royalpayne/dual_zone_12v_HVAC-Controller/docs/IMG_8782.jpeg

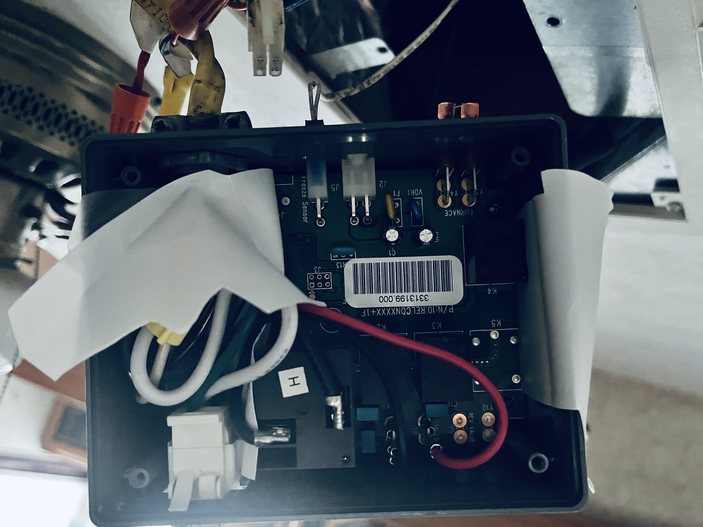
docs/IMG_8782.jpeg
