royalpayne/dual_zone_12v_HVAC-Controller/docs/IMG_8777.jpeg

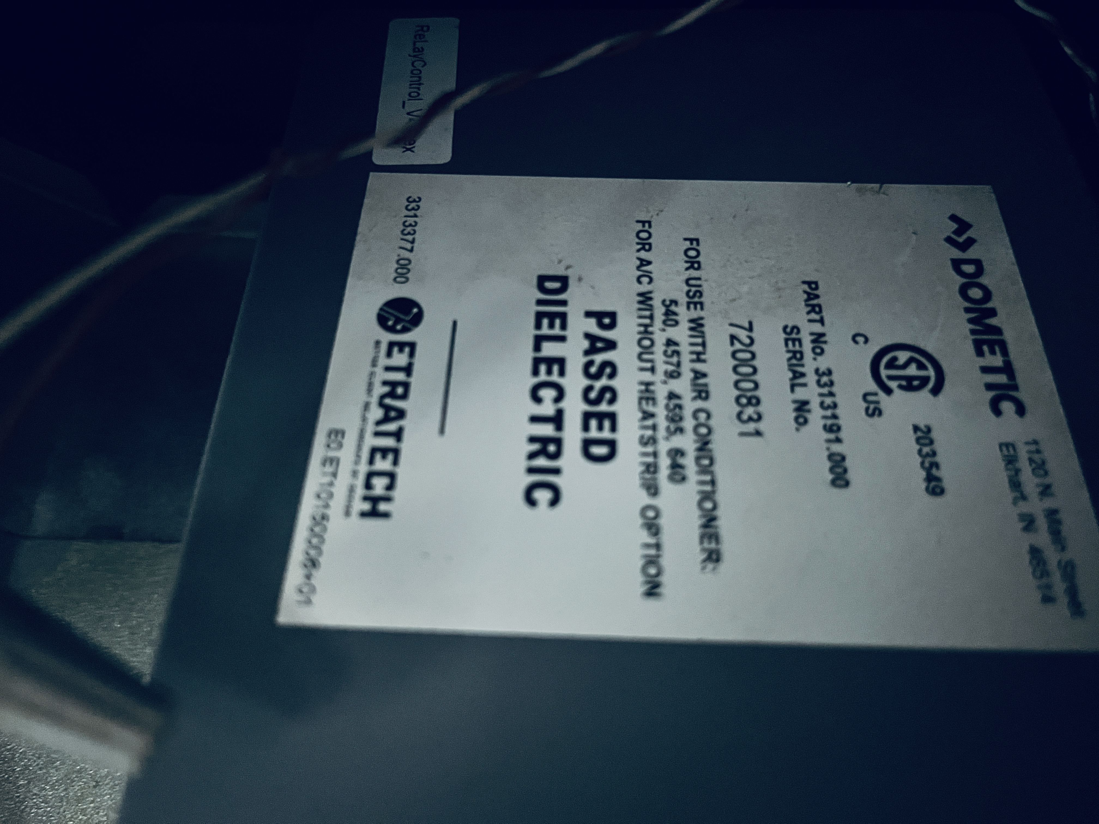
docs/IMG_8777.jpeg
