royalpayne/dual_zone_12v_HVAC-Controller/docs/IMG_8779.jpeg

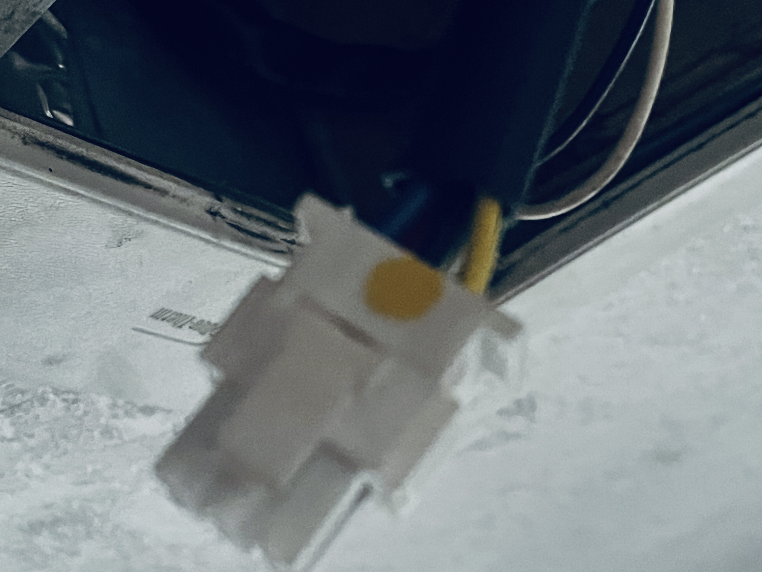
docs/IMG_8779.jpeg
