royalpayne/dual_zone_12v_HVAC-Controller/docs/IMG_8780.jpeg

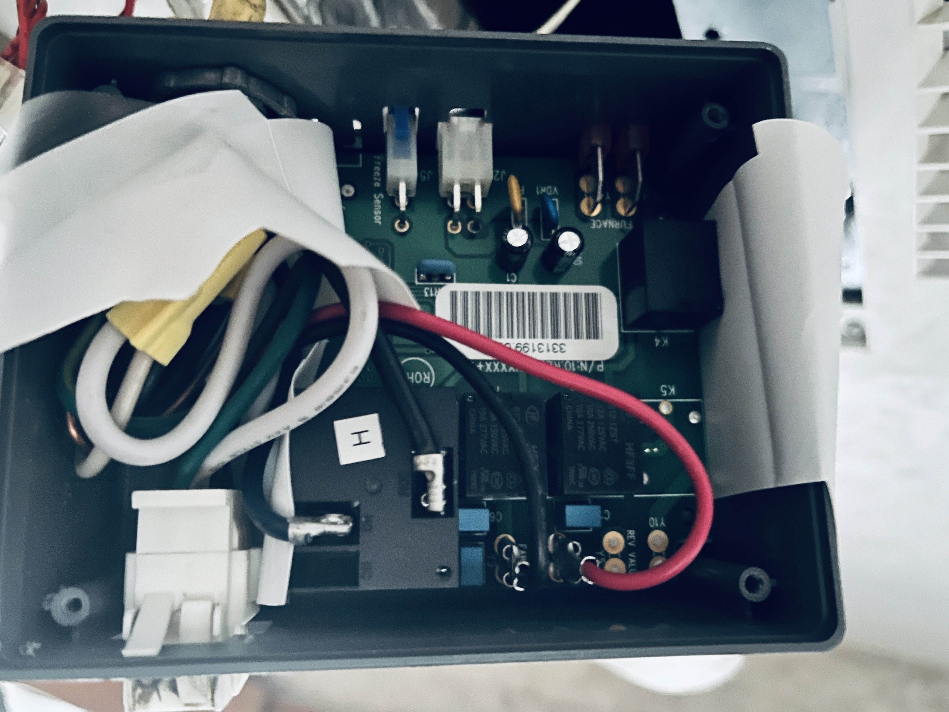
docs/IMG_8780.jpeg
