royalpayne/dual_zone_12v_HVAC-Controller/docs/IMG_8781.jpeg

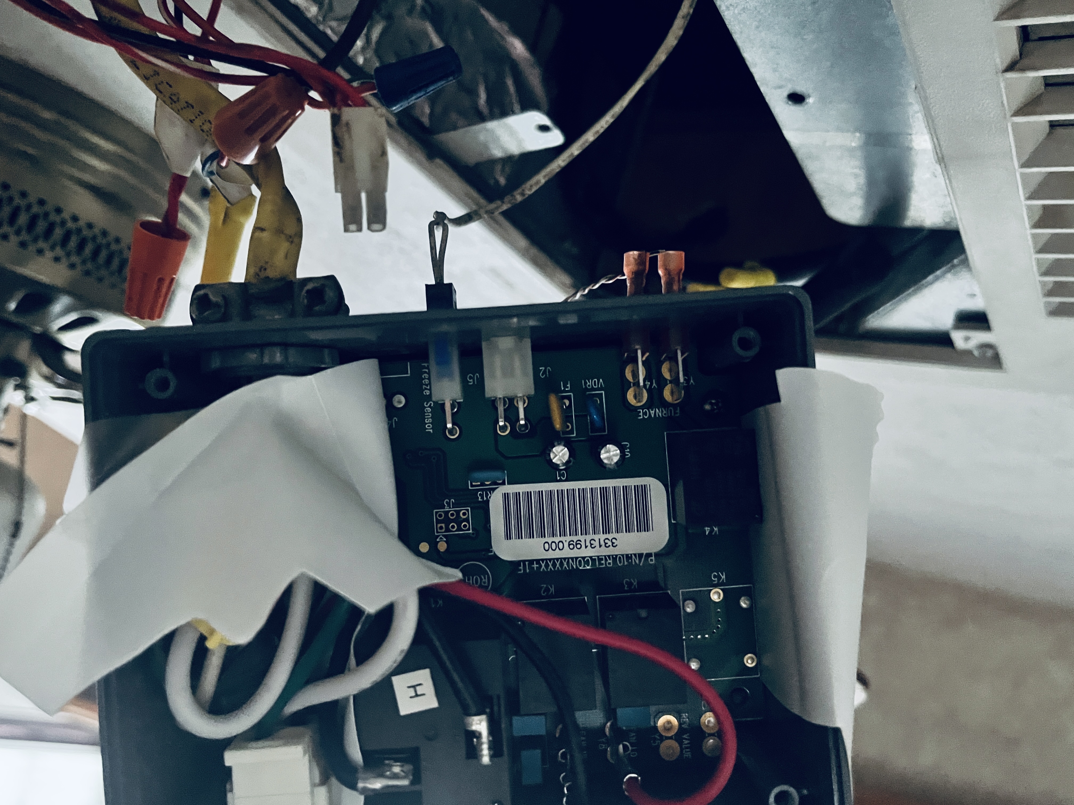
docs/IMG_8781.jpeg
