royalpayne/dual_zone_12v_HVAC-Controller/docs/oled_bme280_wiring_pro.pdf

# OLED & BME280 I2C WIRING DIAGRAM

### 3-Meter Cable: ESP32-S3 Module Thermostat Location

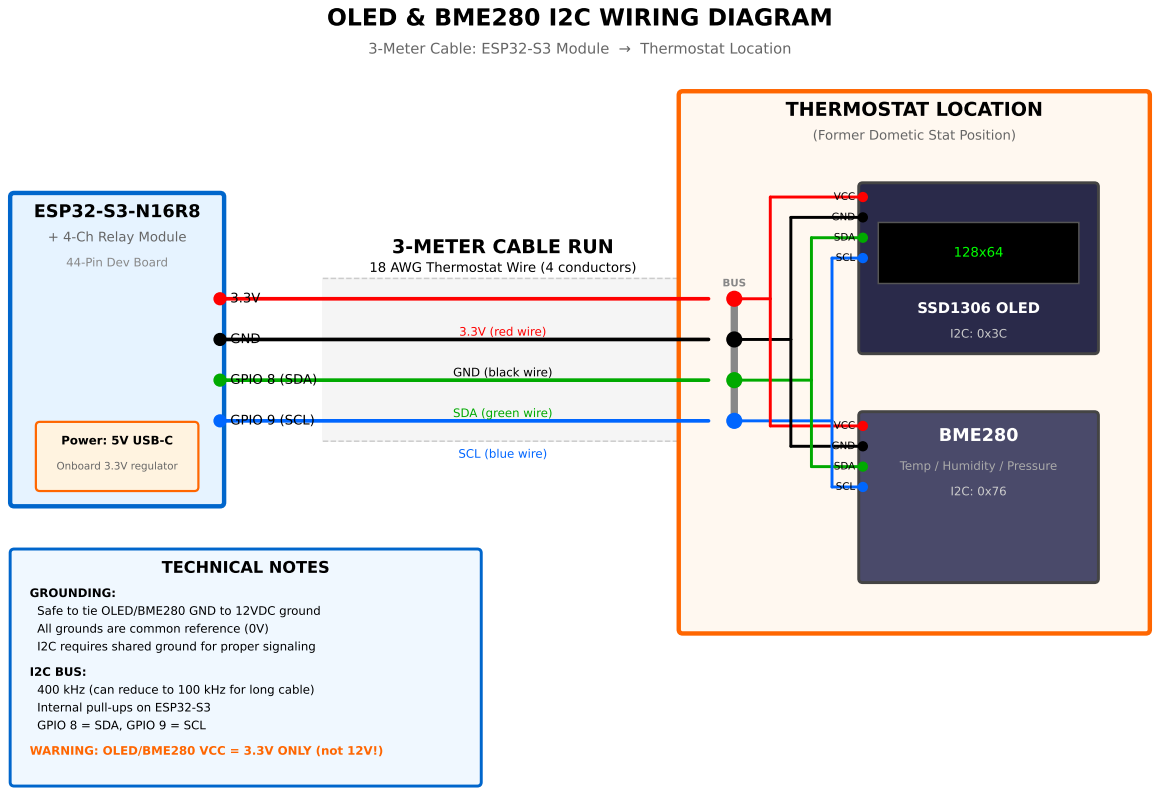
[picture p6: page 1]
ESP32-S3-N16R8; Power: 5V USB-C; Onboard 3.3V regulator; GND; GPIO 8 (SDA); GPIO 9 (SCL); 3.3V (red wire); THERMOSTAT LOCATION; BUS; SSD1306 OLED; VCC; SDA; SCL; BME280; TECHNICAL NOTES

(Former Dometic Stat Position)

+ 4-Ch Relay Module

3-METER CABLE RUN
18 AWG Thermostat Wire (4 conductors)

44-Pin Dev Board

GND (black wire)

SDA (green wire)

SCL (blue wire)

Temp / Humidity / Pressure

GROUNDING:
Safe to tie OLED/BME280 GND to 12VDC ground
All grounds are common reference (0V)
I2C requires shared ground for proper signaling

I2C BUS:
400 kHz (can reduce to 100 kHz for long cable)
Internal pull-ups on ESP32-S3
GPIO 8 = SDA, GPIO 9 = SCL

WARNING: OLED/BME280 VCC = 3.3V ONLY (not 12V!)
