royalpayne/dual_zone_12v_HVAC-Controller/docs/esp32_main_wiring_pro.pdf

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

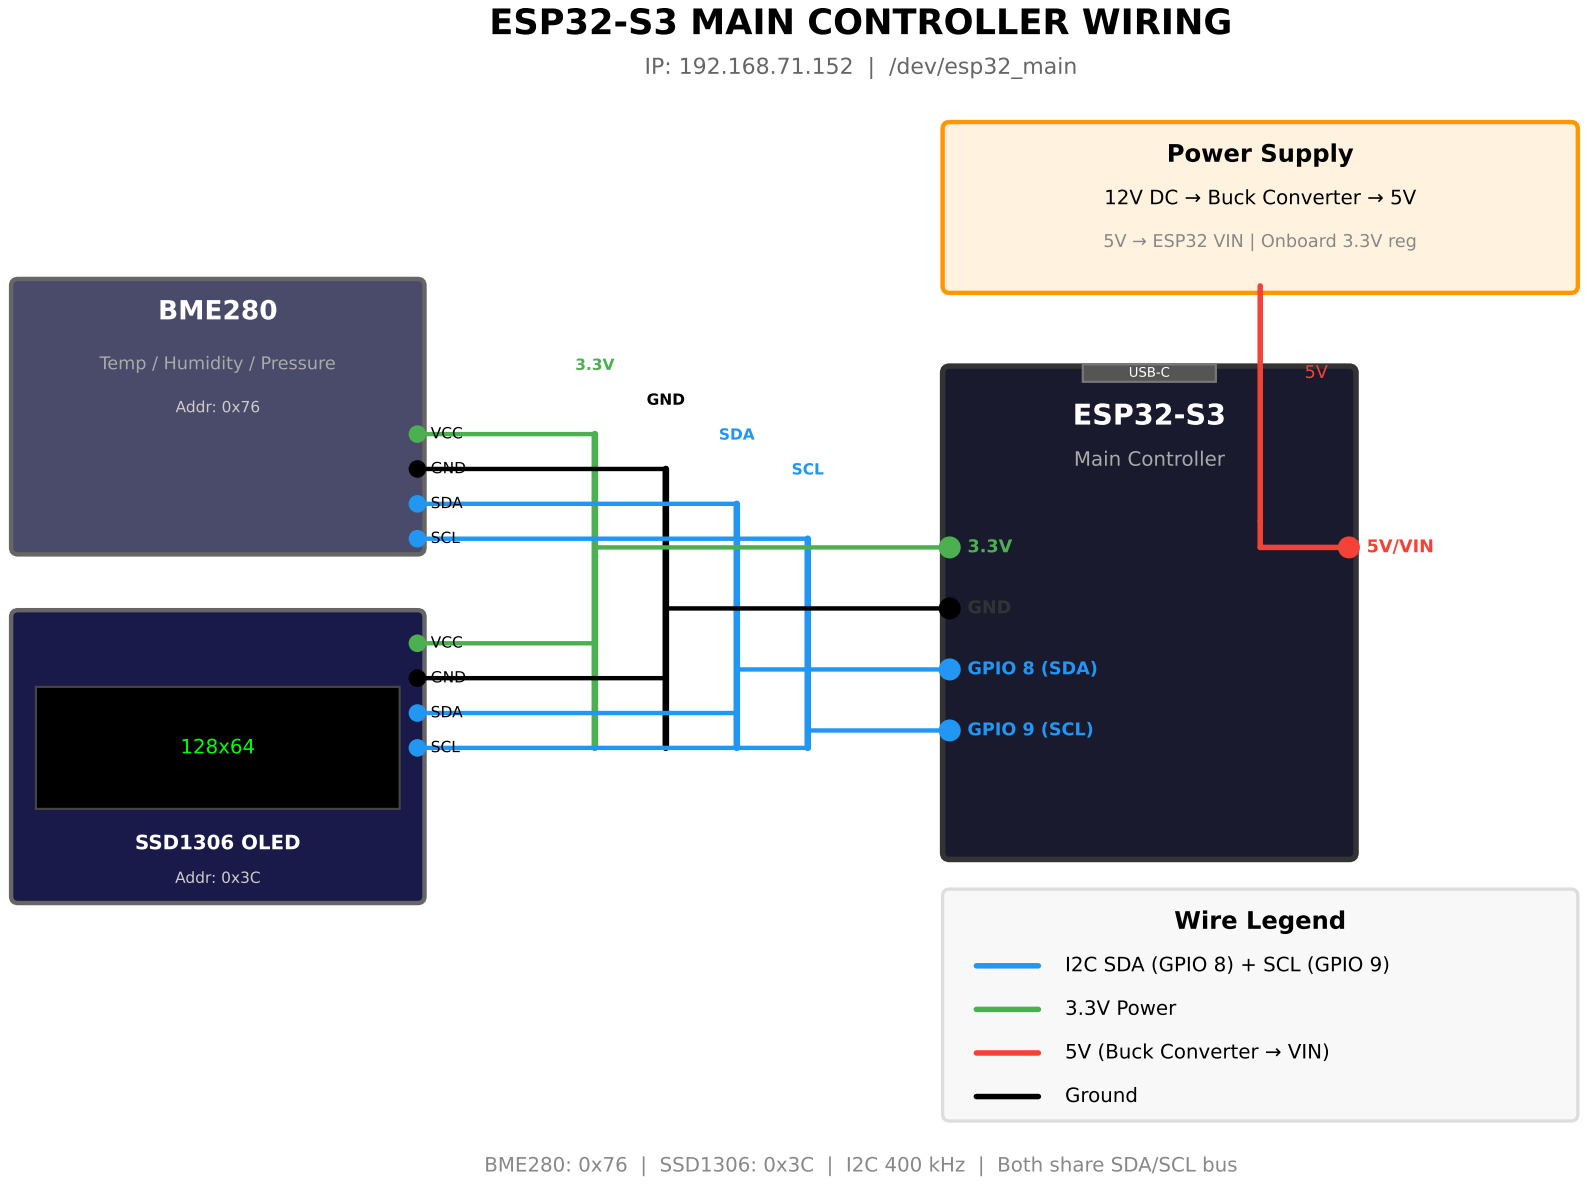
[picture p7: page 1]
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
