royalpayne/dual_zone_12v_HVAC-Controller/(list of files, drawings)

Other design files:
peterhinch_ir/images/circuits.fzz
