royalpayne/dual_zone_12v_HVAC-Controller/esp32_remote/config.py

# ESP32 Remote - Configuration
# ============================

# WiFi Settings (override in config_local.py)
WIFI_SSID = "YOUR_WIFI_SSID"
WIFI_PASSWORD = "YOUR_WIFI_PASSWORD"

# Static IP Configuration (ESP32 Remote)
STATIC_IP = "192.168.71.153"
SUBNET_MASK = "255.255.255.0"
GATEWAY = "192.168.71.1"
DNS_SERVER = "192.168.71.1"

# ESP32 Main Controller (for future API integration)
ESP32_IP = "192.168.1.100"
ESP32_PORT = 80

# Temperature Settings (in Fahrenheit)
DEFAULT_HEAT_SETPOINT = 68
DEFAULT_COOL_SETPOINT = 75
MIN_SETPOINT = 50
MAX_SETPOINT = 90

# Sensor calibration offsets (added to raw readings)
TEMP_OFFSET = -0.6      # degrees F (split-the-difference vs HTS2)
HUMIDITY_OFFSET = -3.3   # percent (split-the-difference vs HTS2)
PRESSURE_OFFSET = 0.0   # hPa

# Broadlink HTS2 calibration offsets
BL_TEMP_OFFSET = 0.6    # degrees F (split-the-difference vs BME280)
BL_HUMIDITY_OFFSET = 3.3  # percent (split-the-difference vs BME280)

# Hysteresis (prevents rapid cycling)
HYSTERESIS = 1.5

# Boost mode - portable unit kicks in when temp exceeds setpoint by this amount
BOOST_THRESHOLD = 4  # degrees F — raised from 3° (comfort avg was +0.1°, room to spare)
BOOST_STALL_TIME = 600  # seconds (10 min) - boost if rooftop AC runs this long with no temp drop

# Dehumidification (via Whynter cool mode - evaporates condensate out exhaust)
HUMIDITY_SETPOINT = 55      # % RH — trigger Whynter when exceeded
HUMIDITY_HYSTERESIS = 8     # % RH — turn off at setpoint minus this (e.g. 55-8=47%)
DEHUM_SUSTAINED_TIME = 300  # seconds (5 min) — humidity must stay above setpoint this long before activating
DEHUM_MIN_RUN_TIME = 1800   # seconds (30 min) — minimum dehum run time once started
DEHUM_MIN_OFF_TIME = 1200   # seconds (20 min) — minimum off time before restarting dehum

# Apparent temperature: adjust cooling decisions based on humidity for comfort + efficiency
# Each 10% RH above 50% feels ~1°F warmer; below 50% feels ~1°F cooler
# Effect: AC runs sooner when humid (dehumidifies), rests longer when dry (saves energy)
HUMIDITY_COMFORT_FACTOR = 0.1  # °F per 1% RH deviation from 50%

# Phase 1 Expansion Features
# CH5/CH6 relay expansion (currently disabled - no hardware)
DEHUMIDIFIER_ENABLE = False     # No standalone dehumidifier (Whynter is IR-controlled)
DEHUMIDIFIER_HUMIDITY_SETPOINT = 60  # % RH — activate dehumidifier above this
DEHUMIDIFIER_HYSTERESIS = 5     # % RH — turn off at setpoint minus this
DEHUMIDIFIER_MIN_CYCLE = 300    # seconds — minimum run/off time (5 min)

# Powered vent fan control (CH6) - MaxxFan, Fantastic Fan, etc
VENT_FAN_ENABLE = False         # No powered vent fan hardware
VENT_FAN_TEMP_DIFFERENTIAL = 5  # °F — run fan when outdoor temp is this much cooler than indoor
VENT_FAN_MAX_OUTDOOR_TEMP = 78  # °F — don't run vent fan if outdoor temp exceeds this
VENT_FAN_MIN_CYCLE = 180        # seconds — minimum run/off time (3 min)

# Short-cycle protection (minimum seconds between state changes)
MIN_CYCLE_TIME = 240  # 4 minutes — reduces short cycling, protects compressor

# Sensor Settings
SENSOR_READ_INTERVAL = 5  # seconds between readings

# Debug and dry-run modes
DEBUG = False
DRY_RUN = False

# ============================================================
# HARDWARE CONFIGURATION - ESP32-S3-N16R8 + 4-Channel Relay Module
# ============================================================
# GPIO 22-25 don't exist on ESP32-S3
# GPIO 26-37 reserved for Flash/PSRAM
# GPIO 19/20 reserved for native USB

# I2C for BME280 and OLED
I2C_SDA_PIN = 41
I2C_SCL_PIN = 40
I2C_FREQ = 400000

# 4-Channel Relay Module (active HIGH, set via jumper)
RELAY_FURNACE_PIN = 4           # Furnace dry contact closure
RELAY_COMPRESSOR_PIN = 5        # Compressor triggers SSR-40DA via 12VDC
RELAY_FAN_LOW_PIN = 6           # Rooftop AC fan low speed
RELAY_FAN_HIGH_PIN = 15         # Rooftop AC fan high speed

# Relay polarity: Active HIGH (value=1 = ON, value=0 = OFF)
RELAY_ACTIVE_LOW = False
# Compressor relay switches 12VDC to SSR-40DA (milliamp trigger), SSR switches 120VAC

# DS18B20 evaporator freeze sensor (1-Wire)
FREEZE_SENSOR_PIN = 42          # DS18B20 data pin (needs 4.7K pull-up to 3.3V)
FREEZE_THRESHOLD = 32.0         # °F — cut compressor if evaporator drops below this
FREEZE_RECOVERY = 45.0          # °F — allow compressor restart above this temp
FREEZE_CHECK_INTERVAL = 5       # seconds between freeze sensor reads

# Onboard WS2812 RGB LED
RGB_LED_PIN = 48                # WS2812 NeoPixel for status indication

# Broadlink RM4 Mini (WiFi IR blaster - replaces direct IR hardware)
BROADLINK_IP = None       # Set after discovery, or static IP in config_local.py
BROADLINK_TIMEOUT = 3     # UDP timeout seconds
BROADLINK_RETRIES = 3     # Retry count for failed commands

# I2C Addresses
BMP280_ADDR = 0x76
OLED_ADDR = 0x3C

# Display Settings
DISPLAY_WIDTH = 128
DISPLAY_HEIGHT = 64

# ============================================================
# CONSTANTS
# ============================================================

# Operating Modes
MODE_OFF = 0
MODE_HEAT = 1
MODE_COOL = 2
MODE_AUTO = 3

MODE_NAMES = {
    MODE_OFF: "OFF",
    MODE_HEAT: "HEAT",
    MODE_COOL: "COOL",
    MODE_AUTO: "AUTO"
}

# Fan Speed (no medium - only 2 speeds to fit 5-wire cable)
FAN_OFF = 0
FAN_LOW = 1
FAN_HIGH = 2
FAN_AUTO = 3

FAN_NAMES = {
    FAN_OFF: "Off",
    FAN_LOW: "Low",
    FAN_HIGH: "High",
    FAN_AUTO: "Auto"
}

# Compressor protection (seconds)
COMPRESSOR_MIN_OFF_TIME = 180   # 3 minutes between off→on
FAN_PRE_RUN = 3                 # Fan starts 3s before compressor
FAN_POST_RUN = 30               # Fan runs 30s after compressor stops

# ============================================================
# LOCAL OVERRIDES
# ============================================================

try:
    from config_local import *
except ImportError:
    pass
