royalpayne/dual_zone_12v_HVAC-Controller/main.py

# RV Thermostat - Main Entry Point
# ================================
# 
# Upload all .py files to your ESP32, then reset.
# Connect to the WiFi and open the IP address in your browser.

import time
import network
from machine import Pin, I2C

import config
from sensor import SensorHub
from ssd1306 import SSD1306_I2C
from display import ThermostatDisplay
from remote_client import RemoteClient
from thermostat_remote import RemoteThermostatController
from webserver import ThermostatWebServer
from scheduler import Scheduler

# Remote ESP32 IP (can be overridden in config_local.py)
REMOTE_IP = getattr(config, 'REMOTE_IP', '192.168.71.153')


def connect_wifi(display):
    """Connect to WiFi network with static IP"""
    wlan = network.WLAN(network.STA_IF)

    # On warm restart (OTA deploy), WiFi is already connected — skip re-init
    # to avoid tearing down the network stack (ESP32-S3 fails to reconnect)
    if wlan.active() and wlan.isconnected():
        ip = wlan.ifconfig()[0]
        print(f"Already connected: {ip}")
        if display:
            display.draw_wifi_status(True, ip)
        return ip

    # Full init sequence for cold boot
    wlan.active(False)
    time.sleep(0.5)
    wlan.active(True)
    time.sleep(1)

    # Configure static IP before connecting
    wlan.ifconfig((config.STATIC_IP, config.SUBNET_MASK, config.GATEWAY, config.DNS_SERVER))
    print(f"Static IP configured: {config.STATIC_IP}")

    print(f"Connecting to {config.WIFI_SSID}...")
    if display:
        display.draw_wifi_status(False)

    # ESP32 needs disconnect before connect
    wlan.disconnect()
    time.sleep(0.5)

    try:
        wlan.connect(config.WIFI_SSID, config.WIFI_PASSWORD)
    except OSError as e:
        print(f"Connect error: {e}, retrying...")
        time.sleep(1)
        wlan.connect(config.WIFI_SSID, config.WIFI_PASSWORD)

    # Wait for connection with timeout
    max_wait = 20
    while max_wait > 0:
        if wlan.isconnected():
            break
        max_wait -= 1
        print(".", end="")
        time.sleep(1)

    if not wlan.isconnected():
        print("\nWiFi connection failed!")
        if display:
            display.draw_error("WiFi Failed")
        return None

    ip = wlan.ifconfig()[0]
    print(f"\nConnected: {ip}")
    if display:
        display.draw_wifi_status(True, ip)
    time.sleep(2)
    return ip


def main():
    """Main entry point"""
    # Initialize I2C
    i2c = I2C(0, 
              sda=Pin(config.I2C_SDA_PIN), 
              scl=Pin(config.I2C_SCL_PIN), 
              freq=config.I2C_FREQ)
    
    # Initialize OLED display
    try:
        oled = SSD1306_I2C(config.DISPLAY_WIDTH, config.DISPLAY_HEIGHT, i2c, config.OLED_ADDR)
        display = ThermostatDisplay(oled)
        display.draw_startup()
    except Exception as e:
        print(f"OLED init failed: {e}")
        display = None
    
    # Initialize sensors (BME280/BMP280)
    sensor = SensorHub(i2c)
    sensor_status = sensor.get_status()
    print(f"Sensor: {sensor_status['sensor_type']}")
    
    # Connect to WiFi
    if display:
        ip = connect_wifi(display)
    else:
        ip = None
        wlan = network.WLAN(network.STA_IF)
        wlan.active(True)
        if not wlan.isconnected():
            wlan.connect(config.WIFI_SSID, config.WIFI_PASSWORD)
            time.sleep(10)
        if wlan.isconnected():
            ip = wlan.ifconfig()[0]
    
    # Start WebREPL for over-the-air updates (port 8266)
    if ip:
        import webrepl
        webrepl.start()
        print(f"WebREPL: ws://{ip}:8266")

    # Sync RTC from NTP server
    if ip:
        import ntptime
        ntptime.host = getattr(config, 'NTP_HOST', 'pool.ntp.org')
        for _ntp_attempt in range(3):
            try:
                ntptime.settime()
                _lt = time.localtime(time.time() + config.TIMEZONE_OFFSET * 3600)
                print(f"NTP synced: {_lt[0]}-{_lt[1]:02d}-{_lt[2]:02d} {_lt[3]:02d}:{_lt[4]:02d}:{_lt[5]:02d}")
                break
            except Exception as e:
                print(f"NTP attempt {_ntp_attempt + 1} failed: {e}")
                time.sleep(1)
        else:
            print("NTP sync failed — timestamps will be inaccurate")

    # Initialize remote ESP32 client for relay/IR control
    remote = RemoteClient(REMOTE_IP)
    print(f"Remote ESP32 at {REMOTE_IP}")

    # Initialize thermostat controller (controls remote ESP32)
    thermostat = RemoteThermostatController(remote)

    # Initialize scheduler
    scheduler = Scheduler(thermostat)

    # Initialize web server (pass remote client for direct API access)
    webserver = ThermostatWebServer(thermostat, scheduler, remote)
    if ip:
        webserver.start()
        print(f"Open http://{ip} in your browser")
    
    # Initialize USB battery keep-alive (prevents auto-shutoff)
    keepalive_pin = None
    if getattr(config, 'KEEPALIVE_ENABLED', False):
        try:
            keepalive_pin = Pin(config.KEEPALIVE_PIN, Pin.OUT)
            keepalive_pin.off()
            print(f"USB keep-alive enabled on GPIO {config.KEEPALIVE_PIN}")
        except Exception as e:
            print(f"Keep-alive init failed: {e}")

    # Main loop
    last_sensor_read = 0
    last_keepalive = 0
    last_history_record = 0
    history_interval = getattr(config, 'HISTORY_INTERVAL', 60)

    print("Thermostat running... Press Ctrl+C to stop")
    
    while True:
        try:
            # Handle web requests
            webserver.handle_requests()
            
            # Read sensors periodically
            now = time.time()

            # USB battery keep-alive pulse (draw current to prevent auto-shutoff)
            if keepalive_pin and (now - last_keepalive >= config.KEEPALIVE_INTERVAL):
                keepalive_pin.on()
                time.sleep_ms(config.KEEPALIVE_PULSE_MS)
                keepalive_pin.off()
                last_keepalive = now

            if now - last_sensor_read >= config.SENSOR_READ_INTERVAL:
                temp_f, humidity, pressure = sensor.read()
                thermostat.update_readings(temp_f, humidity, pressure)
                last_sensor_read = now
                
                # Run scheduler (checks time-based mode changes)
                scheduler.run()

                # Run control logic
                thermostat.run_control_loop()
                
                # Record history snapshot for data logging
                if now - last_history_record >= history_interval:
                    try:
                        webserver.record_snapshot()
                    except Exception as e:
                        print(f"History record error: {e}")
                    last_history_record = now

                # Update display
                if display:
                    display.draw_main_screen(
                        temp_f, humidity, pressure,
                        thermostat.mode,
                        thermostat.heat_setpoint,
                        thermostat.cool_setpoint,
                        thermostat.heating_active,
                        thermostat.cooling_active
                    )
            
            time.sleep(0.1)
            
        except KeyboardInterrupt:
            print("\nStopping...")
            break
        except Exception as e:
            print(f"Error: {e}")
            time.sleep(1)


if __name__ == "__main__":
    main()
