royalpayne/dual_zone_12v_HVAC-Controller/_restart.py

# _restart.py — warm restart helper (exec'd via WebREPL after OTA upload)
# Purges cached user modules so fresh code loads from flash, then re-runs main.py.
# WiFi + WebREPL stay up because their modules are preserved.
import sys
import gc

_keep = set('sys gc machine network webrepl _webrepl websocket socket'
            ' uos os micropython esp esp32 time struct io json errno'
            ' select binascii hashlib collections re math _thread ssl'
            ' ntptime framebuf btree onewire ds18x20'.split())
n = 0
for _m in list(sys.modules):
    if _m not in _keep:
        del sys.modules[_m]
        n += 1
del _keep
gc.collect()
print('Purged', n, 'modules, free=', gc.mem_free())
# Clear I2C bus before re-running main — 9 SCL pulses releases any stuck slave
try:
    import config as _cfg
    from machine import Pin
    import time as _t
    _scl = Pin(_cfg.I2C_SCL_PIN, Pin.OUT)
    for _ in range(9):
        _scl.value(1); _t.sleep_us(5)
        _scl.value(0); _t.sleep_us(5)
    _scl.value(1)
    del _scl, _cfg, _t, Pin
except Exception:
    pass

# exec main.py then call main() — __name__ != '__main__' in exec context
_ns = {}
exec(open('main.py').read(), _ns)
_ns['main']()
