royalpayne/dual_zone_12v_HVAC-Controller/esp32_remote/ssd1306.py

# SSD1306 OLED Driver for MicroPython
# 128x64 I2C display

from micropython import const
import framebuf

# Commands
SET_CONTRAST = const(0x81)
SET_ENTIRE_ON = const(0xA4)
SET_NORM_INV = const(0xA6)
SET_DISP = const(0xAE)
SET_MEM_ADDR = const(0x20)
SET_COL_ADDR = const(0x21)
SET_PAGE_ADDR = const(0x22)
SET_DISP_START_LINE = const(0x40)
SET_SEG_REMAP = const(0xA0)
SET_MUX_RATIO = const(0xA8)
SET_COM_OUT_DIR = const(0xC0)
SET_DISP_OFFSET = const(0xD3)
SET_COM_PIN_CFG = const(0xDA)
SET_DISP_CLK_DIV = const(0xD5)
SET_PRECHARGE = const(0xD9)
SET_VCOM_DESEL = const(0xDB)
SET_CHARGE_PUMP = const(0x8D)


class SSD1306_I2C(framebuf.FrameBuffer):
    def __init__(self, width, height, i2c, addr=0x3C):
        self.i2c = i2c
        self.addr = addr
        self.width = width
        self.height = height
        self.pages = height // 8
        self.buffer = bytearray(self.pages * width)
        super().__init__(self.buffer, width, height, framebuf.MONO_VLSB)
        self._init_display()

    def _init_display(self):
        for cmd in (
            SET_DISP | 0x00,  # Display off
            SET_MEM_ADDR, 0x00,  # Horizontal addressing
            SET_DISP_START_LINE | 0x00,
            SET_SEG_REMAP | 0x01,  # Column 127 mapped to SEG0
            SET_MUX_RATIO, self.height - 1,
            SET_COM_OUT_DIR | 0x08,  # Scan from COM[N] to COM0
            SET_DISP_OFFSET, 0x00,
            SET_COM_PIN_CFG, 0x12 if self.height == 64 else 0x02,
            SET_DISP_CLK_DIV, 0x80,
            SET_PRECHARGE, 0xF1,
            SET_VCOM_DESEL, 0x30,
            SET_CONTRAST, 0xFF,
            SET_ENTIRE_ON,  # Output follows RAM
            SET_NORM_INV,  # Not inverted
            SET_CHARGE_PUMP, 0x14,  # Enable charge pump
            SET_DISP | 0x01,  # Display on
        ):
            self._write_cmd(cmd)
        self.fill(0)
        self.show()

    def _write_cmd(self, cmd):
        self.i2c.writeto(self.addr, bytes([0x80, cmd]))

    def _write_data(self, buf):
        self.i2c.writeto(self.addr, bytes([0x40]) + buf)

    def show(self):
        self._write_cmd(SET_COL_ADDR)
        self._write_cmd(0)
        self._write_cmd(self.width - 1)
        self._write_cmd(SET_PAGE_ADDR)
        self._write_cmd(0)
        self._write_cmd(self.pages - 1)
        self._write_data(self.buffer)

    def poweroff(self):
        self._write_cmd(SET_DISP | 0x00)

    def poweron(self):
        self._write_cmd(SET_DISP | 0x01)

    def contrast(self, contrast):
        self._write_cmd(SET_CONTRAST)
        self._write_cmd(contrast)

    def invert(self, invert):
        self._write_cmd(SET_NORM_INV | (invert & 1))
