royalpayne/dual_zone_12v_HVAC-Controller/(commit log)

2026-01-31 Migrate remote controller from Raspberry Pi Pico W to ESP32
    Major Changes:
    - Updated pin configurations to ESP32 GPIO layout
    * I2C: GPIO 0,1 → 21,22
    * DHT11: GPIO 2 → 4
    * Relays: GPIO 15,16 → 25,26
    * IR: GPIO 17 → 18 (added GPIO 19 for RX)
    - Updated WiFi initialization for ESP32
    * Added wlan.active(False/True) sequence
    * Added wlan.disconnect() before connect
    * Added OSError exception handling
    - Created boot.py for ESP32 auto-start
    * Automatically runs main.py on boot
    * Includes error handling and reporting
    - Fixed sensor formatting bugs
    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
    [bmp280.py, boot.py, config.py, config_dev.py, config_prod.py, config_test.py, display.py, env.py]
2026-01-31 Remove all Raspberry Pi Pico references
    Changes:
    - Renamed pico_remote/ → esp32_remote/
    - Renamed deploy_pico_remote.sh → deploy_esp32_remote.sh
    - Renamed class PicoAPI → RemoteAPI
    - Updated all documentation references
    - Changed "Pico Remote" → "ESP32 Remote" in code
    - Updated API variable names (PICO_IP → REMOTE_IP)
    All references to Pico hardware removed from codebase.
2026-01-31 Final cleanup: Remove all remaining Pico references
    - Project description now refers to dual ESP32 system
    - pico_client.py → remote_client.py
    - test_pico.py → test_remote.py
    - API endpoints updated
    - All documentation references cleaned up
    Raspberry Pi Pico completely removed from project.
2026-01-31 Complete Pico removal: Fix all remaining references
    Fixed:
    - claude.md: API endpoints and communication descriptions
    - config.py/config_local.py: File headers
    - thermostat.py: File header
    - Last updated message clarified
    Project now fully references ESP32 only.
    [config.py, thermostat.py]
2026-01-31 Add migration success report
    Comprehensive documentation of successful Pico W → ESP32 migration:
    - All completion criteria met
    - System running and stable
    - API server functional
    - Documentation complete
    - Ready for hardware testing phase
    Migration Status: ✅ COMPLETE
2026-01-31 Add comprehensive SVG wiring diagram and fix deployment script
    - Created dual_esp32_wiring.svg with complete hardware layout
    - Color-coded wiring with no overlapping connections
    - Shows ESP32 Main and ESP32 Remote configurations
    - Fixed deploy_esp32_remote.sh to work with running program
    - Changed device detection to simple file check (no exec needed)
2026-01-31 Update README.md for dual ESP32 architecture
    - Changed title from "Pico W" to "Dual ESP32 System"
    - Updated hardware descriptions for both ESP32s
    - Added reference to wiring/dual_esp32_wiring.svg
    - Updated pin mappings from Pico to ESP32 GPIO
    - Revised installation instructions for ESP32 deployment
    - Added API testing commands
2026-01-31 Create separate wiring diagrams for each ESP32
    - Split dual_esp32_wiring.svg into two focused diagrams
    - esp32_main_wiring.svg: Main controller (BMP280 + OLED)
    - esp32_remote_wiring.svg: Remote controller (full HVAC hardware)
    - Cleaner layouts with no overlapping connections
    - Power distribution shown as reference only
    - Color-coded wiring with detailed legends
    - Hardware notes included on each diagram
    - Updated README.md to reference both diagrams
2026-01-31 Remove old dual_esp32_wiring.svg
    Replaced with cleaner separate diagrams:
    - esp32_main_wiring.svg
    - esp32_remote_wiring.svg
2026-01-31 Redesign wiring diagrams with visible GPIO labels
    - ESP32 pins now extend outward with labels positioned clear of wires
    - All wiring routes below/around ESP32 board to avoid covering labels
    - Gold pin connectors clearly visible on all components
    - Improved readability with larger, golden GPIO labels
    - Wire paths designed to avoid text overlap
    - Maintains color-coding: red (power), black (ground), green (SDA),
    blue (SCL), magenta (data), orange (relay), pink (IR)
2026-01-31 Add BME280 support with auto-detection
    Hardware:
    - Updated ESP32 Main wiring diagram for BME280 (6 pins)
    - BME280 uses I2C mode: VCC, GND, SCL, SDA (MISO and CS unused)
    - Shows unused SPI pins greyed out on diagram
    - I2C address: 0x76 (same as BMP280)
    Software:
    - Created bme280.py driver with full humidity support
    - Updated sensor.py to auto-detect BME280 or BMP280
    - BME280 provides temp + humidity + pressure (replaces BMP280 + DHT11)
    - Backward compatible with existing BMP280 setups
    - DHT11 used as backup if BME280 humidity fails
    Benefits:
    - Single sensor for all measurements on ESP32 Main
    - More accurate humidity than DHT11
    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
    [bme280.py, sensor.py]
2026-01-31 Add ESP32 Main setup and deployment scripts
    - flash_esp32_main.sh: Flash MicroPython firmware to new ESP32
    - deploy_esp32_main.sh: Deploy all main controller files
    - Includes BME280 driver in deployment
    - Auto-detects config_local.py for WiFi credentials
    - Scripts accept device path as optional parameter
    Usage:
    ./flash_esp32_main.sh /dev/ttyUSB0
    ./deploy_esp32_main.sh /dev/ttyUSB0
2026-01-31 Complete ESP32 Main setup and deployment
    - Fixed flash_esp32_main.sh with current MicroPython firmware URL
    - Updated deploy_esp32_main.sh to include env.py and pico_client.py
    - Successfully deployed ESP32 Main at 192.168.71.152
    - API server running and responding correctly
    - BME280 driver ready for hardware connection
    Tested and verified:
    - WiFi connection established
    - Web server running on port 80
    - API returning valid JSON
    - Sensor auto-detection working (ENODEV expected without hardware)
    Next: Wire BME280 and OLED to ESP32 Main
2026-01-31 Simplify web UI and update remote controller references
    - Remove schedule UI (card, CSS, JavaScript) to reduce memory usage
    - Update all "Pico" references to "Remote" throughout interface
    - Add ESP32 Remote flash and deployment scripts
    - Simplify scheduler from 7 days to weekday/weekend format
    - Reduce HTML size from ~407 to ~312 lines (7.5KB payload)
    Website now loads reliably on ESP32 with 112KB free memory.
2026-01-31 Add graphical humidity and pressure indicators
    OLED Display:
    - Add water droplet icon (7x9 pixels) next to humidity reading
    - Add pressure trend arrows: ↑ rising, ↓ falling, → steady
    - Track pressure history (3 readings) to calculate trend
    - Threshold: ±0.5 hPa for rising/falling detection
    Web UI:
    - Add 💧 emoji before humidity percentage
    - Add dynamic pressure trend arrow that updates with API
    - Track pressure history on server side
    - Include pressure_trend field in API /status response
    Both displays now provide visual context for environmental data
    making it easier to understand conditions at a glance.
2026-01-31 Refactor pico to remote naming and fix slider UX issues
    - Rename pico_client.py to remote_client.py with RemoteClient class
    - Update all references from "pico" to "remote" across codebase
    - Increase socket timeout from 0.5s to 2.0s for reliable ESP32-to-ESP32 communication
    - Add JavaScript debouncing (300ms) to prevent slider conflicts
    - Add adjustment flags to prevent polling updates during user interaction
    - Fix sensor display reliability issues
    - Various sensor and display improvements
    [display.py, main.py, remote_client.py, sensor.py, thermostat_remote.py, webserver.py]
2026-01-31 Set default mode to AUTO and increase sensor polling to 10 seconds
    - Add DEFAULT_MODE config setting (default: AUTO)
    - Update thermostat to use config.DEFAULT_MODE instead of hardcoded MODE_OFF
    - Increase SENSOR_READ_INTERVAL from 5 to 10 seconds for reduced overhead
2026-01-31 Fix slider race condition with improved debouncing
    - Increase debounce timeout from 300ms to 500ms
    - Add 500ms delay before clearing adjusting flags after API response
    - Prevents 3-second polling from interfering with slider updates
    - Fixes cool slider jumping when moving to higher temperatures
    - Applied to all four sliders (heat, cool, remote heat, remote cool)
    [webserver.py]
2026-01-31 Fix slider jumping by removing immediate updates after API calls
    - Remove upd(d) and updRemote(d) calls after setpoint API responses
    - Increase protection delay from 500ms to 1000ms after API completes
    - Let regular 3-second polling handle slider updates naturally
    - Eliminates race condition between API response and polling cycle
    - Slider now stays exactly where user sets it
    [webserver.py]
2026-01-31 Display both heat and cool setpoints on OLED screens
    - Update draw_main_screen() to accept both heat_setpoint and cool_setpoint
    - Display format: "H:68 C:75" instead of single setpoint
    - Applied to both main ESP32 and remote ESP32 displays
    - Shows both setpoints regardless of current mode
2026-02-03 Upgrade Main to ESP32-S3 with BME280, add humidity/pressure to web UI
    - Update Main config for ESP32-S3 I2C pins (GPIO 8/9)
    - Add BME280 driver to Remote ESP32
    - Fix pressure units (Pa to hPa conversion)
    - Display humidity and pressure for both Main and Remote zones
    - Show humidity as whole number percentages
    - Update IR transmitter to use digital signal (module handles carrier)
    - Add IR LED and receiver test scripts
    [bme280.py, config.py, ir_whynter.py, main.py, remote_client.py, sensor.py, thermostat.py, webserver.py]
2026-02-03 Add Arduino IR transmitter sketch for testing
    - Uses IRremoteESP8266 library with proper 38kHz carrier
    - Alternative to MicroPython for IR testing
    - Hardware IR LED still needs fixing
2026-02-04 Switch IR transmission to ESP32 RMT hardware for reliable control
    Updated WhynterIR to use ESP32's RMT peripheral instead of software PWM
    for more precise IR timing. Tested and working at 1 meter distance with
    2N2222 transistor driver circuit on 5V power.
    - Use RMT hardware for 38kHz carrier generation and precise timing
    - Add peterhinch IR library for capture/transmit support
    - Include test scripts for debugging IR transmission
    - Add wiring diagram for transistor driver circuit
    - Update claude.md with testing results and working configuration
    Hardware requirements:
    - 2N2222 NPN transistor for LED driver
    - 5V power supply for maximum LED brightness
    - 22Ω current-limiting resistor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
    [circuits.fzz]
2026-02-04 Update IR testing log with 2026-02-04 results
    Testing revealed that 4 IR LEDs with 2N2222 transistor driver on 5V
    can control the Whynter A/C, but without proper current limiting the
    operation is inconsistent at 1 meter range.
    Key findings:
    - ESP32 RMT hardware transmission working correctly
    - NEC protocol IR code captured and validated
    - Transistor circuit functional but needs current regulation
    - Inconsistent results without resistor (LEDs may overheat)
    Next steps:
    - Install 22Ω resistor when it arrives for stable 150mA current
    - Should provide reliable 1+ meter range with proper LED protection
2026-02-05 Fix ESP32 firmware mismatch, improve IR transmission, fix web UI
    Hardware fixes:
    - Reflashed Remote with correct ESP32 firmware (was incorrectly using S3)
    - Updated claude.md to reflect correct board assignments:
    * Main = ESP32-S3 with BME280
    * Remote = ESP32 (30-pin) with BME280 (DHT11 replaced)
    IR improvements:
    - Increased duty cycle from 50% to 75% in ir_whynter.py
    - Successfully tested IR transmission at 1 meter
    - Whynter A/C control confirmed working
    - All IR functions verified to use RMT hardware transmission
    Web UI fix:
    - Changed client.send() to client.sendall() in both webservers
    - Increased timeout from 2s to 5s for large HTML responses
    - Fix ready for deployment after power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
    [ir_whynter.py, webserver.py]
2026-02-06 Simplify Whynter control, remove DHT11, reduce boost threshold
    - Whynter control simplified to ON/OFF only (defaults to cool mode)
    - Removed DEHUM and HEAT buttons from web UI
    - BOOST_THRESHOLD reduced from 10°F to 5°F
    - Removed all DHT11 code (BME280 provides temp/humidity/pressure)
    - Updated sensor.py to BME280/BMP280 only
    - Updated config files to remove DHT11_PIN
    - Updated main.py sensor status messages
2026-02-08 Add Broadlink IR control, Whynter protocol, fan speed relays, parallel AC wiring
    Major changes:
    - Add Broadlink RM4 Mini client for WiFi IR blasting (broadlink_client.py)
    - Rewrite Whynter IR to protocol-based (no learned codes needed, ESPHome ARC-14SH)
    - Add Dr. Heater IR controller (learned codes via Broadlink)
    - Add fan speed relay control (low/high) for Dometic Brisk II rooftop AC
    - Add compressor short-cycle protection and fan pre/post-run timers
    - Add /api/whynter endpoint for direct portable AC control
    - Fix thermostat_remote.py pico→remote naming, set_rooftop→set_mode
    - Add parallel thermostat wiring diagram and ESP32 wiring diagram
    - Add udev rules for persistent ESP32 USB symli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
    [boot.py, broadlink_client.py, config.py, ir_heater.py, ir_whynter.py, main.py, remote_client.py, thermostat.py]
2026-02-08 Add Dr. Heater IR control with captured raw codes
    The Dr. Heater (humidifier model) uses a proprietary IR protocol,
    not standard NEC. Power code captured from physical remote and
    hardcoded. Additional buttons can be learned via API endpoint.
    Also updated webserver with /api/heater endpoint.
2026-02-08 Update Dr. Heater IR to non-humidifier model
    Replaced captured power code with new non-humidifier Dr. Heater remote
    (294 bytes, different proprietary protocol from humidifier model).
    [ir_heater.py]
2026-02-08 Refresh wiring diagrams: remove IR transmitter, add Broadlink
    - esp32_wiring_diagram: Remove GPIO 17/18 IR TX/RX, add Broadlink
    RM4 Mini as WiFi IR blaster, update pinout tables
    - fan_relay_wiring: Fix Active HIGH (was Active LOW), remove GPIO 41
    - fan_relay_breadboard: Same fixes, 2-channel layout
    - Add wiring photos
2026-02-09 Active HIGH relays, Broadlink keepalive, Whynter boost, sensor calibration
    - Switch all 4 relays to active HIGH logic (GPIO 38-41)
    - Fix Broadlink sleep: re-auth inside retry loop + 5-min keepalive ping
    - Fix IR state tracking: only update on successful Broadlink send
    - Fix control loop killing manual Whynter override in MODE_OFF
    - Add Whynter stall boost: auto-enable after 10min rooftop AC with no temp drop
    - Add BME280 sensor calibration offsets (TEMP_OFFSET, HUMIDITY_OFFSET, PRESSURE_OFFSET)
    - Add auto-sync: Kitchen settings push to Remote every 60 seconds
    - Remove dead Rooftop/Portable cooling system selector (cool_system)
    - Update wiring diagrams for active HIGH relay polarity
    Co-Autho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
    [boot.py, broadlink_client.py, config.py, ir_whynter.py, main.py, sensor.py, thermostat.py, thermostat_remote.py]
2026-02-17 Dehum/furnace fix, data logging, OTA deploy, Dometic direct wiring docs
    Thermostat:
    - Fix dehumidification fighting furnace: guard against heating_active,
    temperature floor at heat_setpoint + HYSTERESIS
    - Add humidity-adjusted apparent temperature for cooling decisions
    - Expand Whynter modes (cool/dehum/fan/heat) with named mode mapping
    - Add Broadlink HTS2 sensor readings to thermostat status
    - Add humidity setpoint and dehum_active to status API
    Data logging:
    - Add NTP time sync on Main ESP32 after WiFi connect (UTC-6 Central)
    - Add circular history buffer in webserver with /api/history endpoint
    - Add 60-second recording timer in main loop
    - Add PC-side data_logger.py with SQLite storag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
    [broadlink_client.py, config.py, data_logger.py, deploy_ota.py, generate_wiring_pdf.py, main.py, remote_client.py, thermostat.py]
2026-02-17 SSR-25DA compressor switching, Supco SFPC freeze stat, DS18B20 freeze protection
    Replace HL-52S direct 120VAC compressor switching with SSR-25DA solid state
    relay (25A) triggered via 12VDC from Relay 2. HL-52S handles fans only.
    Add DS18B20 freeze sensor on GPIO 42 with software cutoff at 32F/recovery
    at 45F. Hardware backup via Supco SFPC clamp-on freeze stat (opens 35F).
    Update wiring diagram SVG, PDF instructions, and CLAUDE.md for new architecture.
    Remove IR TX/RX GPIO references (replaced by Broadlink RM4 Mini).
    [config.py, generate_wiring_pdf.py, main.py, thermostat.py]
2026-02-20 IR heater force-off, OTA WebREPL fixes, hardware replacement
    - Add force-off API for IR heater to fix out-of-sync state
    - New /api/heater?power=force_off sends IR regardless of tracked state
    - Syncs both HeaterController.power_on and ThermostatController.heater_mode
    - FORCE OFF button in web UI with optimistic update for immediate feedback
    - Fix OTA deployment via WebREPL (deploy_ota.py)
    - Rewrite to use raw WebSocket protocol (mpremote ws: doesn't support special chars)
    - Critical fix: _handshake() reads 1 byte at a time to avoid consuming WebSocket frames
    - Soft reset after deploy (boards often require power cycle to come back online)
    - Replace damaged Remote ESP32-S3-N16R8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
    [config.py, deploy_ota.py, ir_heater.py, main.py, remote_client.py, webserver.py]
2026-02-20 Add universal force-all-off emergency shutdown
    - Add force_all_off() to thermostat controller (esp32_remote/thermostat.py)
    - Unconditionally turns off all relays (furnace, compressor, fans)
    - Force-sends IR off to Whynter and heater (ignores tracked state)
    - Resets all state variables (mode, whynter_mode, heater_mode, etc.)
    - Add /api/force_all_off endpoint (esp32_remote/webserver.py)
    - Add force_all_off() to remote client (remote_client.py)
    - Update Main ESP32 web UI (webserver.py)
    - Replace heater-only FORCE OFF with universal FORCE ALL OFF button
    - Red styling under "EMERGENCY SHUTDOWN" section
    - Optimistically sets all buttons to OFF state when clicked
    - Fixes out-of-sync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
    [remote_client.py, thermostat.py, webserver.py]
2026-02-20 Disable automatic reset in OTA deployment
    - Remove _soft_reset() call after file upload
    - machine.reset() leaves boards offline (WiFi/network stack doesn't reinitialize)
    - User manually power cycles when ready to load new code
    - Update CLAUDE.md to document manual power cycle requirement
    Fixes persistent issue where ESP32s go offline after OTA updates
    [deploy_ota.py]
2026-02-20 Use soft_reset for OTA deployment instead of hard reset
    - Change from machine.reset() to machine.soft_reset()
    - Soft reset only resets Python interpreter, WiFi stays connected
    - Boards should come back online within 5-10 seconds
    - Eliminates need for manual power cycling after OTA updates
    - Critical for ESP32s installed in difficult-to-reach locations
    machine.reset() was causing boards to go offline because it does a full
    hardware reset, requiring WiFi reconnection which sometimes fails.
    [deploy_ota.py]
2026-02-20 Revert to no automatic reset for OTA deployment
    Testing confirms both machine.reset() and machine.soft_reset() cause
    boards to go offline when called via WebREPL. Network stack doesn't
    reinitialize properly after any type of reset.
    - Remove automatic reset call from deploy script
    - Files upload successfully, boards stay online
    - Manual power cycle required to load new code
    - Document that automatic reset is not reliable via WebREPL
    - Suggest remote power switch (smart plug) for true remote OTA
    This is the only reliable approach that keeps boards online after upload.
    [deploy_ota.py]
2026-02-20 Document all WebREPL reset methods fail, revert to manual power cycle
    Tested all available reset methods via WebREPL on ESP32-S3 + MicroPython v1.27.0:
    ❌ machine.reset() - hard reset causes boards to go offline
    ❌ machine.soft_reset() - soft reset causes boards to go offline
    ❌ machine.deepsleep(500) - full hardware reset causes boards to go offline
    Root cause: Known issue with ESP32-S3/MicroPython v1.27.0 where network
    stack doesn't properly reinitialize after programmatic reset via WebREPL.
    Boards either crash during reset/wake or fail to reconnect WiFi.
    References:
    - GitHub issue #167: WiFi hangs if connection present on second run
    - GitHub discussion #9331: machine.reset() doesn't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
    [deploy_ota.py]
2026-02-21 Add Phase 1 enhancements: RGB LED status indicator and buzzer alerts
    Integrate Waveshare ESP32-S3-Relay-6CH onboard peripherals for visual
    and audio feedback. RGB LED shows thermostat state (heating=red,
    cooling=blue, freeze=blink red, etc). Buzzer sounds freeze alerts
    with rate limiting. New API endpoints for buzzer/LED control. Updated
    boot.py GPIO pins for Waveshare module. Disabled CH5/CH6 relay
    features (no hardware). Replaced SVG diagrams with professional PDFs.
    [boot.py, config.py, create_diagrams_updated.py, rgb_led.py, thermostat.py, webserver.py]
2026-02-21 Improve wiring diagrams: fix label overlap, add SVG output
    - Rewrite all 4 diagram functions with orthogonal wire routing
    - Fix wire labels overlapping lines (increased offsets, proper va alignment)
    - Reroute Fan Low/High wires around Load Chain box in relay splice
    - Add DS18B20 three-lead wiring (VCC, Data, GND) in relay splice
    - Add SVG output alongside PDF for all diagrams
    - Update CLAUDE.md with wiring diagram documentation
    [create_diagrams_updated.py]
2026-02-24 Remove deprecated IR/Pico hardware refs, clean up legacy files
    - Remove all IR LED, IR receiver, 2N2222, and Pico W references from
    code comments, config, and documentation
    - Delete 60+ deprecated files: peterhinch_ir/, arduino_ir/, files (7)/,
    files (8)/, legacy test scripts, old shell scripts, obsolete docs
    - Rewrite README.md for current Waveshare + Broadlink architecture
    - Update CLAUDE.md, config.py, thermostat_remote.py, generate_wiring_pdf.py
    - Rename last_pico_sync → last_remote_sync in thermostat_remote.py
    - Add _restart.py warm restart helpers for OTA deployment
    - Add auto-sync toggle, warm restart, and Waveshare wiring updates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
    [circuits.fzz]
2026-02-27 Update Remote to ESP32-S3-N16R8 devboard with external relay module
    - Replace Waveshare 6CH relay board with N16R8 + 4-channel relay module
    - New GPIO assignments: relays 4/5/6/15, I2C 41/40, DS18B20 42, RGB 48
    - Remove reset button (GPIO 2) — replaced by 12V toggle switch
    - Remove buzzer.py (no buzzer on N16R8 board)
    - Add I2C scan and 1-Wire scan diagnostic API endpoints
    - Regenerate all wiring diagrams with updated pin assignments
    - Update all documentation for new hardware configuration
    [boot.py, config.py, create_diagrams_updated.py, generate_wiring_pdf.py, rgb_led.py, thermostat.py, webserver.py]
2026-02-28 Update SSR-25DA to SSR-40DA after relay failure, fix GPIO refs in docs
    SSR-25DA failed shorted (triac stuck closed, passed 120V with control off).
    Replaced with SSR-40DA (40A) for better thermal margin on Brisk II compressor.
    Also corrected GPIO 7→15 (fan high) and GPIO 15→42 (DS18B20) in wiring PDF,
    removed reset button references from all documentation.
    [create_diagrams_updated.py, generate_wiring_pdf.py]
2026-03-01 Add dehum anti-cycling, HTS2/BME280 calibration offsets
    Dehumidification now requires humidity to stay above setpoint for 5 min
    (sustained threshold) before activating, enforces 15 min minimum run time,
    and 10 min minimum off time between cycles. Prevents rapid on/off cycling
    from brief humidity spikes in the RV.
    Also adds split-the-difference calibration offsets for Remote BME280 and
    Broadlink HTS2 sensors (temp ±0.7°F, humidity ±1.7%).
    [config.py, thermostat.py]
2026-03-01 Add cool-setpoint temperature guard to dehum control
    Dehum now won't activate (or will stop) when temp is 5°F below the cool
    setpoint. Prevents Whynter from over-cooling the RV when dehumidifying
    in already-cold conditions.
    [thermostat.py]
2026-03-03 Add energy dashboard, scheduler humidity presets, schedule overrides
    Energy panel estimates kWh usage from logged system states with per-component
    breakdown at $0.13/kWh. Scheduler presets now include humidity thresholds
    (home=55%, away=70%, sleep=55%) to reduce Whynter runtime when away.
    Dashboard and ESP32 web UI both have schedule override controls for
    Hold Home/Away with duration buttons and Cancel Hold.
2026-03-03 Add multi-zone temperature awareness for either-area HVAC control
    Remote ESP32 now accepts Main's kitchen temperature via /api/remote_temp
    and uses worst-case across both zones: max(local, kitchen) for cooling,
    min(local, kitchen) for heating. This ensures the AC runs if either area
    exceeds the setpoint, fixing the issue where kitchen was hot (76°F) but
    the Remote's local sensor (72°F) prevented the compressor from starting.
    Main's redundant control loop replaced with temp-send + status-poll —
    Remote is now the sole relay controller, preserving all safety logic
    (freeze protection, compressor min off time, fan pre/post run).
    [remote_client.py, thermostat.py, thermostat_remote.py, webserver.py]
2026-03-03 Fix SQLite thread-safety in dashboard data logger
    Logger thread and main thread were sharing one SQLite connection, causing
    silent failures. Each thread now gets its own connection, and initial
    data pull completes before the server starts.
    [data_logger.py]
2026-03-04 Add timezone and US DST support to scheduler
    Scheduler was using raw UTC from time.localtime() instead of applying
    TIMEZONE_OFFSET, causing schedule entries to trigger at wrong times.
    Added automatic US DST detection (2nd Sunday Mar through 1st Sunday Nov)
    so the scheduler automatically shifts from CST (UTC-6) to CDT (UTC-5)
    during summer months.
    [scheduler.py]
2026-03-04 Add energy dashboard link to ESP32 web UI
2026-03-05 Add btree history persistence and rtcwake auto-sync
    ESP32 history was RAM-only, lost on every reboot. Now persisted to
    flash via MicroPython btree (7-day retention, pruned on boot).
    PC laptop auto-syncs every 2 hours via systemd timer + rtcwake hook
    that wakes the machine from sleep.
    [config.py, webserver.py]
2026-03-07 Add schedule editing UI, paginated history API, and dehum tuning
    - Web UI: collapsible schedule editor with preset temps (heat/cool/humidity)
    and weekday/weekend time slot management
    - Scheduler: set_preset() now preserves humidity field and applies changes
    immediately when editing the active mode
    - History API: paginated with ?limit=N (default 500) to prevent ESP32 OOM
    on large queries; data_logger.py auto-pages through results
    - Dehum anti-cycling: wider deadband (8% hysteresis), longer min run (30m)
    and off time (20m) to reduce on/off cycling
    - Sensor calibration: updated split-the-difference offsets for BME280/HTS2
    - CLAUDE.md: added multi-zone, scheduler, btree, dashboard, sync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
    [config.py, data_logger.py, scheduler.py, webserver.py]
2026-03-07 Fix Whynter boost cycling and average humidity for dehum control
    - Boost anti-cycling: reset stall baseline (cooling_start_time/temp) when
    boost turns off, add 10-min cooldown before re-triggering
    - Dehum now uses _effective_humidity() averaging BME280 + HTS2 sensors
    for more stable readings and fewer false triggers
    [thermostat.py]
2026-03-07 Simplify dehum: let Whynter manage compressor cycling internally
    - ESP32 now only turns Whynter dehum mode on/off, not cycling the compressor
    - Whynter's built-in humidity sensor handles compressor cycling
    - Removed min-run-time and min-off-time anti-cycling (no longer needed)
    - Kept sustained threshold (5 min) to avoid reacting to humidity spikes
    - Kept temperature guards (too cold, heating active)
    - Added _effective_humidity() averaging BME280 + HTS2 for stable readings
    [thermostat.py]
2026-03-10 Add schedule enable/disable toggle to ESP32 UI and PC dashboard
    - ESP32: clickable enable/disable button in Schedule Override card
    - Dashboard: Enable/Disable Schedule button with /api/schedule_enable endpoint
    - Dashboard: show day names (EEE) on x-axis for 3d/7d chart ranges
2026-04-14 Fix warm restart: exec main() explicitly, longer timeouts
    [_restart.py, deploy_ota.py]
2026-04-14 Fix scheduler: evaluate correct mode on boot, persist current_mode across reboots
    [scheduler.py]
2026-04-14 Fix boot mode eval: defer to first run() call so thermostat is ready
    [scheduler.py]
2026-04-14 Fix scheduler: carry over last entry past midnight (fixes 2am showing wrong mode)
    [scheduler.py]
2026-04-14 Fix schedule_mode sync chain + run rooftop fan low during dehum for air circulation
    [remote_client.py, thermostat.py, thermostat_remote.py, webserver.py]
2026-04-20 Add /settings network config page: WiFi, IP, remote ESP32 IP, timezone
2026-05-10 Fix: Whynter flickers on rooftop AC start — add boost_active flag to prevent spurious auto-disable
    [thermostat.py]
2026-05-10 Remote: fall back to kitchen temp when local BME280 sensor is unavailable
2026-05-10 Remote: use kitchen temp fallback at decision points when local sensor unavailable
2026-05-10 Remote: allow control loop to run using kitchen temp fallback when local sensor is null
2026-05-10 Remote: fix boost trigger to use fallback temp when local sensor is null
    [thermostat.py]
2026-05-10 Remote: Whynter state update optimistic on IR send failure (Broadlink timeout workaround)
    [thermostat.py]
2026-06-01 Efficiency tuning: MIN_CYCLE_TIME 30s→4min, BOOST_THRESHOLD 3→4°F
2026-06-01 Add /api/reset HTTP endpoint; deploy_ota uses HTTP reset before WebREPL fallback
    [deploy_ota.py, webserver.py]
2026-06-01 Increase HTTP reset delay 200ms→800ms so response flushes before disconnect
    [webserver.py]
2026-06-01 Fix boot hang on locked I2C bus — guard i2c.scan(), SensorHub skips init when i2c=None
    [main.py, sensor.py]
2026-06-01 Fix I2C bus lockup after reset: send 9 SCL pulses to release stuck slave before restart
    [_restart.py, webserver.py]
